Shubham-Khandelwal1/Aerionix_BLDC_health/bldc_health/EASYEDA_MODELS/LGA-24_L3.0-W3.0-P0.40-TL.step

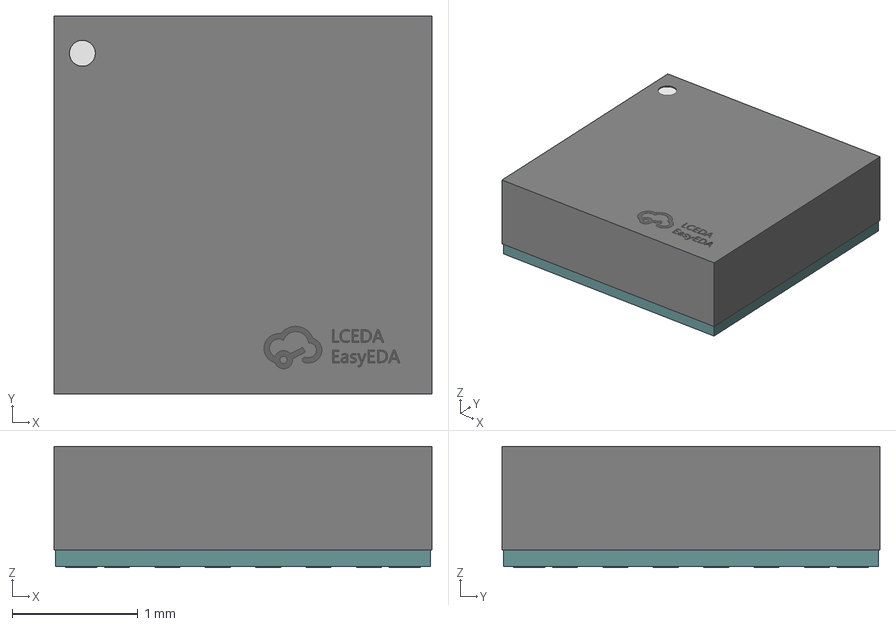
[picture p1: CAD file, 2026-09-08]
bldc_health/EASYEDA_MODELS/LGA-24_L3.0-W3.0-P0.40-TL.step
3.00 x 3.00 x 0.961 mm
