Shubham-Khandelwal1/Aerionix_BLDC_health/bldc_health/footprints_aerionix/TS09-63-25-WT-160-SMT-TR/TS09-63-25-WT-160-SMT-TR.step

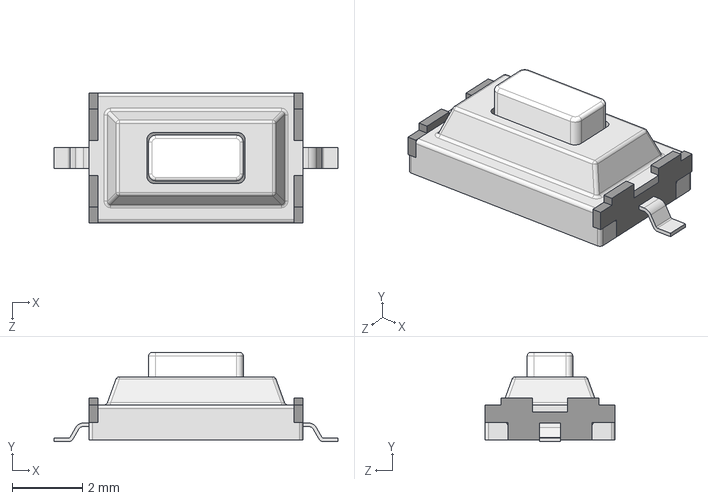
[picture p2: CAD file, 2026-10-23]
bldc_health/footprints_aerionix/TS09-63-25-WT-160-SMT-TR/TS09-63-25-WT-160-SMT-TR.step
8.10 x 2.55 x 3.70 mm
