Shubham-Khandelwal1/Aerionix_BLDC_health/bldc_health/EASYEDA_MODELS/UFQFPN-48_L7.0-W7.0-P0.50-TL-EP5.6.step

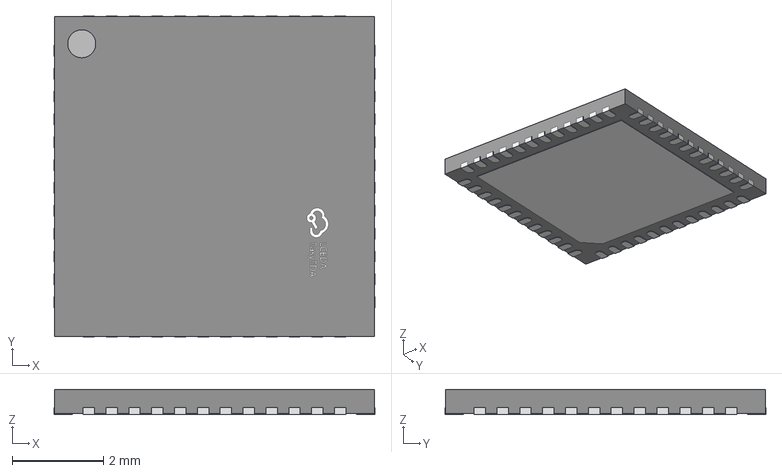
[picture p3: CAD file, 2026-09-08]
bldc_health/EASYEDA_MODELS/UFQFPN-48_L7.0-W7.0-P0.50-TL-EP5.6.step
7.02 x 7.02 x 0.551 mm
