Shubham-Khandelwal1/Aerionix_BLDC_health/bldc_health/EASYEDA_MODELS/LGA-14_L2.5-W3.0-H0.9-P0.50.step

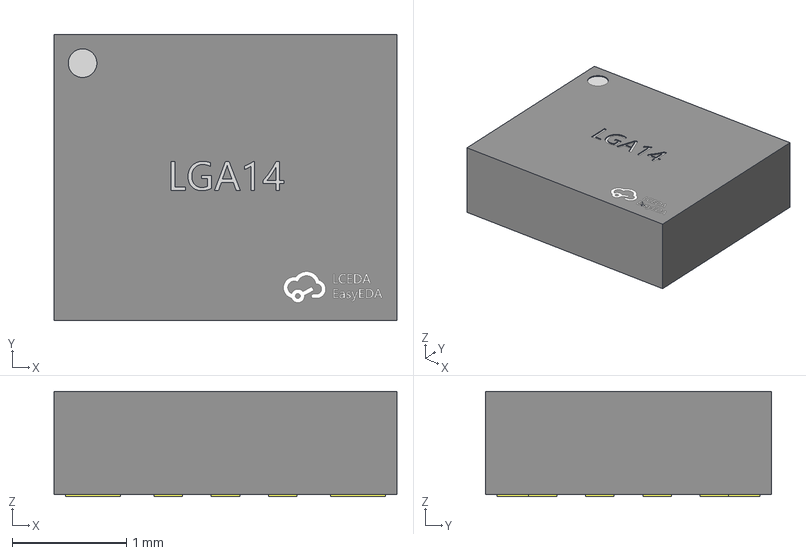
[picture p4: CAD file, 2026-09-08]
bldc_health/EASYEDA_MODELS/LGA-14_L2.5-W3.0-H0.9-P0.50.step
3.00 x 2.50 x 0.921 mm
