Shubham-Khandelwal1/Aerionix_BLDC_health/bldc_health/bldc_health.pdf

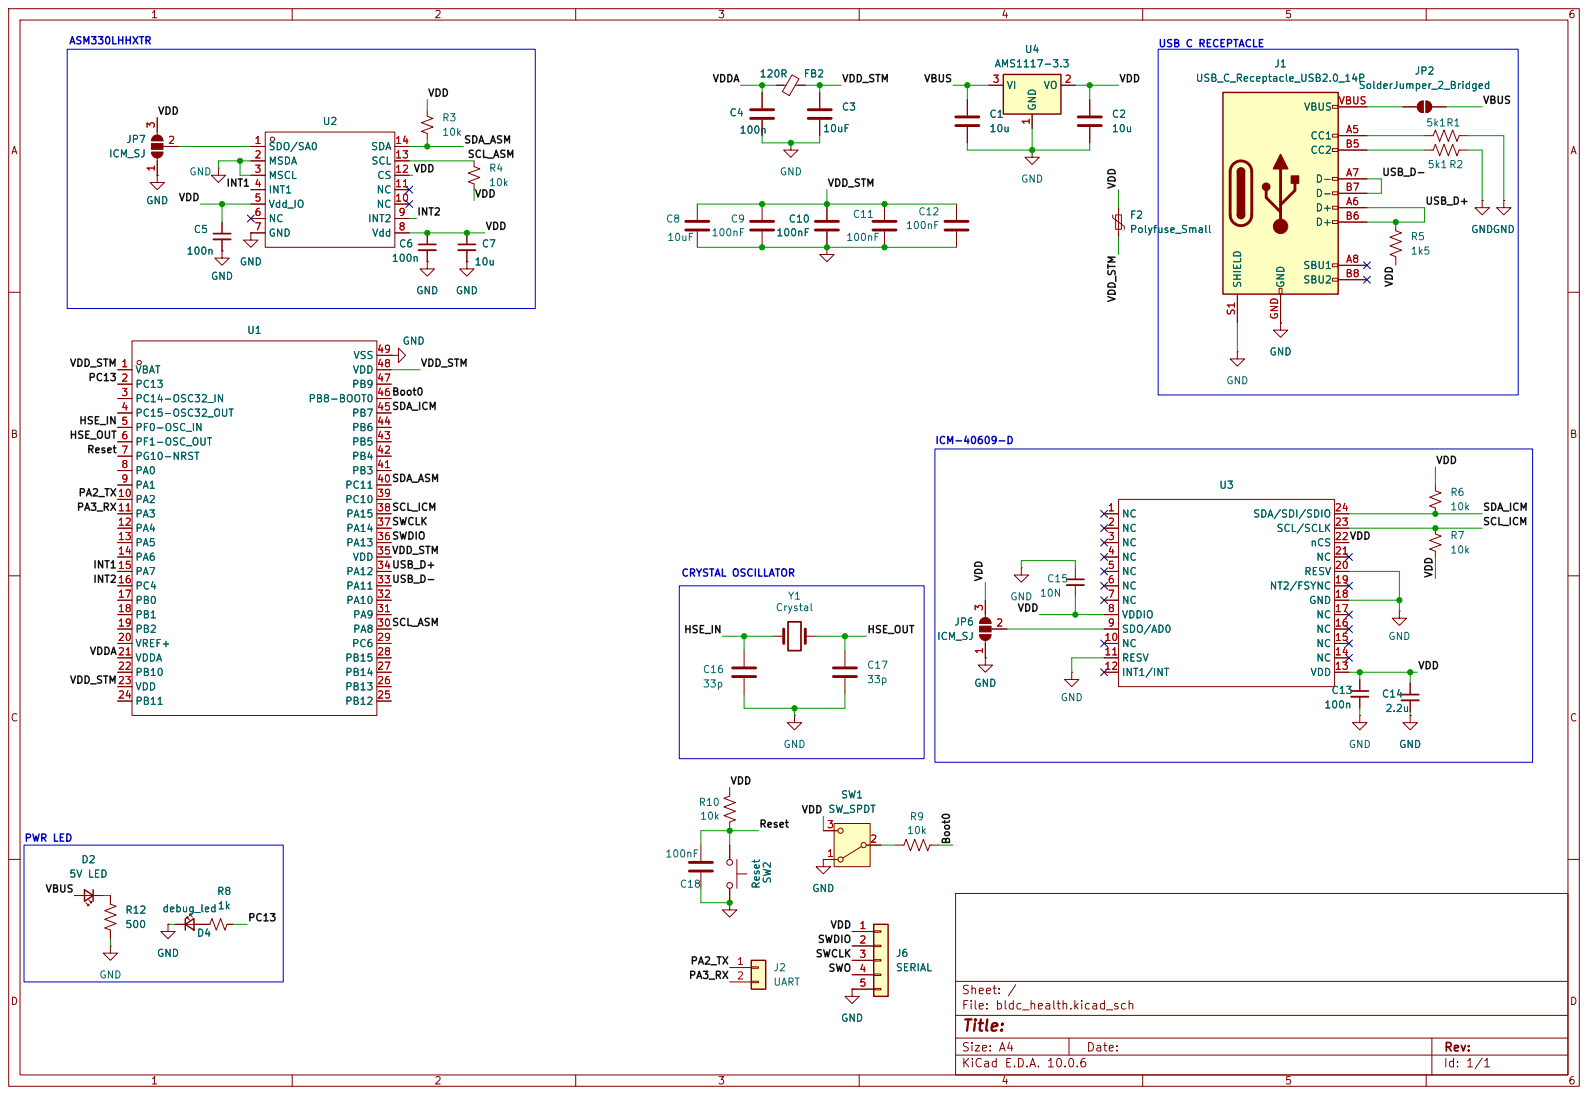
[picture p5: page 1]

Size: A4 | Rev:
KiCad E.D.A. 10.0.6 | Id: 1/1
