Shubham-Khandelwal1/Aerionix_BLDC_health/bldc_health/bldc_health.kicad_pcb

## KiCad design bldc_health/bldc_health.kicad_pcb (2026-10-25)

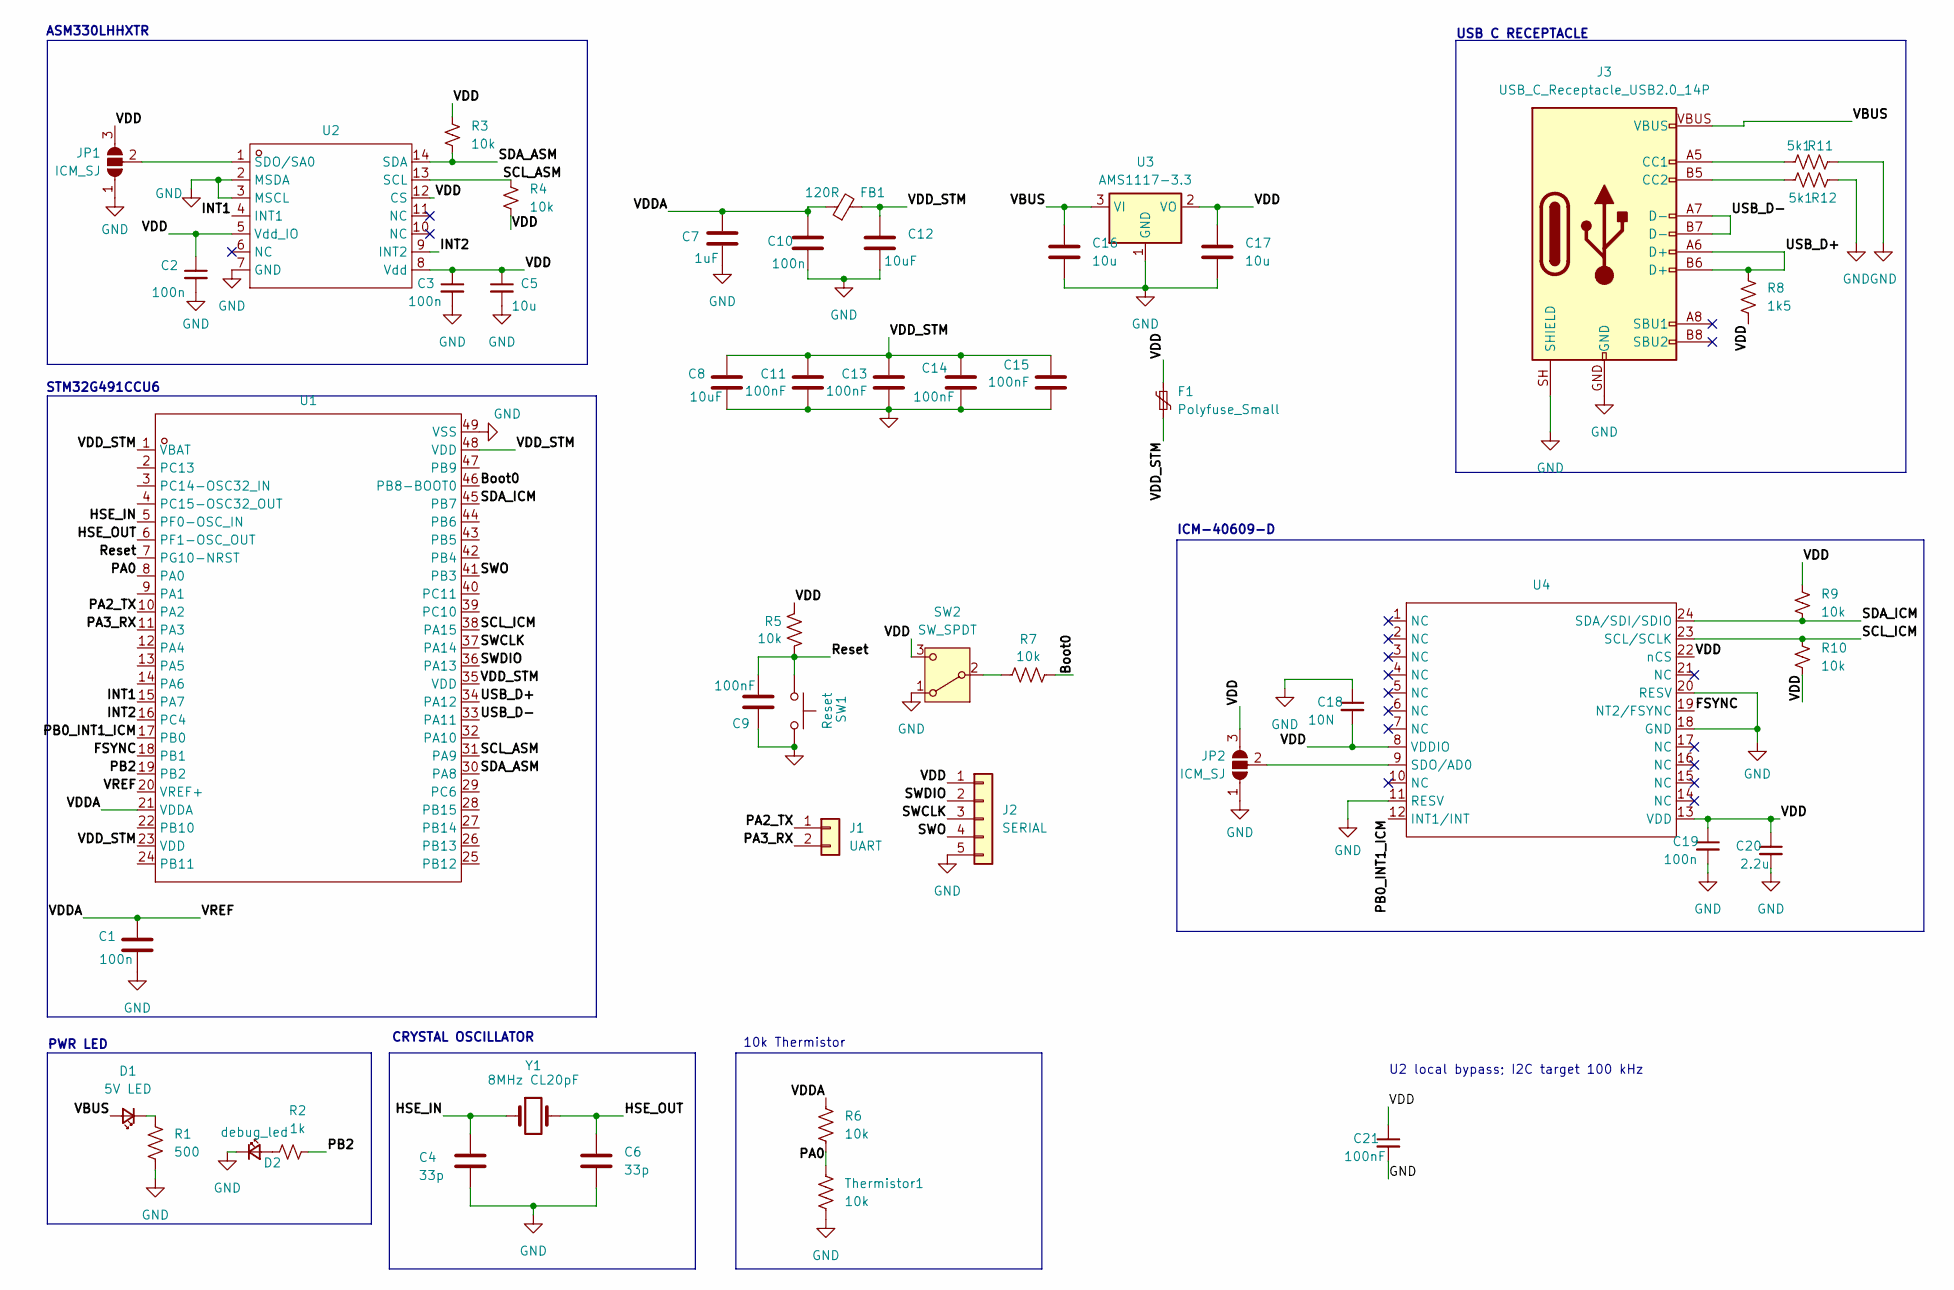
[picture p6: schematic bldc_health.kicad_sch]

Parts:
C1, C2, C3, C10, C19: 100n; C_0603_1608Metric_Pad1.08x0.95mm_HandSolder
C4, C6: 33p; C_0603_1608Metric_Pad1.08x0.95mm_HandSolder
C5, C16, C17: 10u; C_0603_1608Metric_Pad1.08x0.95mm_HandSolder
C7: 1uF; C_0603_1608Metric_Pad1.08x0.95mm_HandSolder
C8, C12: 10uF; C_0603_1608Metric_Pad1.08x0.95mm_HandSolder
C9, C11, C13, C14, C15: 100nF; C_0603_1608Metric_Pad1.08x0.95mm_HandSolder
C18: 10N; C_0603_1608Metric_Pad1.08x0.95mm_HandSolder
C20: 2.2u; C_0603_1608Metric_Pad1.08x0.95mm_HandSolder
C21: 100nF; C_0402_1005Metric
D1: 5V LED; LED_0805_2012Metric_Pad1.15x1.40mm_HandSolder
D2: debug_led; LED_0805_2012Metric_Pad1.15x1.40mm_HandSolder
F1: Polyfuse_Small; Fuse_0603_1608Metric_Pad1.05x0.95mm_HandSolder
FB1: 120R; L_0603_1608Metric_Pad1.05x0.95mm_HandSolder
J1: UART; PinHeader_1x02_P2.54mm_Vertical
J2: SERIAL; PinHeader_1x05_P2.54mm_Vertical
J3: USB_C_Receptacle_USB2.0_14P; USB-C-16P_ARM-PCB
JP1, JP2: ICM_SJ; SolderJumper-3_P1.3mm_Open_Pad1.0x1.5mm
R1: 500; R_0603_1608Metric_Pad0.98x0.95mm_HandSolder
R2: 1k; R_0603_1608Metric_Pad0.98x0.95mm_HandSolder
R3, R4, R5, R6, R7, R9, R10: 10k; R_0603_1608Metric_Pad0.98x0.95mm_HandSolder
R8: 1k5; R_0603_1608Metric_Pad0.98x0.95mm_HandSolder
R11, R12: 5k1; R_0603_1608Metric_Pad0.98x0.95mm_HandSolder
SW1: Reset; SW_TS09-63-25-WT-160-SMT-TR
SW2: SW_SPDT; SW_Slide-03_Wuerth-WS-SLTV_10x2.5x6.4_P2.54mm
Thermistor1: 10k; PinHeader_1x02_P1.00mm_Vertical
U1: UFQFPN-48_L7.0-W7.0-P0.50-TL-EP5.6; Manufacturer Part STM32G491CCU6; LCSC Part Name 主流的 Arm Cortex-M4 微控制器，主频 170 MHz，配备 25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
U2: LGA-14_L3.0-W2.5-P0.50-TL; Manufacturer Part ASM330LHHXTR; LCSC Part Name 高精度6轴汽车惯性测量单元
U3: AMS1117-3.3; SOT-223-3_TabPin2
U4: ICM-40609-D_LGA24_DirectGround; Manufacturer Part ICM-40609-D; LCSC Part Name 6轴MEMS运动跟踪设备
Y1: 8MHz CL20pF; Crystal_SMD_HC49-SD

Connections:
/Boot0: R7.2, U1.46 (PB8-BOOT0)
/FSYNC: U1.18 (PB1), U4.19 (NT2/FSYNC)
/HSE_IN: C4.1, U1.5 (PF0-OSC_IN), Y1.1
/HSE_OUT: C6.1, U1.6 (PF1-OSC_OUT), Y1.2
/INT1: U1.15 (PA7), U2.4 (INT1)
/INT2: U1.16 (PC4), U2.9 (INT2)
/PA0: R6.2, Thermistor1.1, U1.8 (PA0)
/PA2_TX: J1.1, U1.10 (PA2)
/PA3_RX: J1.2, U1.11 (PA3)
/PB0_INT1_ICM: U1.17 (PB0), U4.12 (INT1/INT)
/PB2: R2.2, U1.19 (PB2)
/Reset: C9.2, R5.1, SW1.1, U1.7 (PG10-NRST)
/SCL_ASM: R4.1, U1.31 (PA9), U2.13 (SCL)
/SCL_ICM: R10.1, U1.38 (PA15), U4.23 (SCL/SCLK)
/SDA_ASM: R3.2, U1.30 (PA8), U2.14 (SDA)
/SDA_ICM: R9.2, U1.45 (PB7), U4.24 (SDA/SDI/SDIO)
/SWCLK: J2.3, U1.37 (PA14)
/SWDIO: J2.2, U1.36 (PA13)
/SWO: J2.4, U1.41 (PB3)
/USB_D+: J3.A6 (D+), J3.B6 (D+), R8.1, U1.34 (PA12)
/USB_D-: J3.A7 (D-), J3.B7 (D-), U1.33 (PA11)
/VBUS: C16.1, D1.2 (A), J3.VBUS, U3.3 (VI)
/VDD: C2.1, C3.1, C5.1, C17.1, C18.2, C19.1, C20.1, C21.1, F1.1, J2.1, JP1.3 (B), JP2.3 (B), R3.1, R4.2, R5.2, R8.2, R9.1, R10.2, SW2.3 (C), U2.5 (Vdd_IO), U2.8 (Vdd), U2.12 (CS), U3.2 (VO), U4.8 (VDDIO), U4.13 (VDD), U4.22 (nCS)
/VDDA: C1.1, C7.1, C10.1, FB1.1, R6.1, U1.20 (VREF+), U1.21 (VDDA)
/VDD_STM: C8.1, C11.1, C12.1, C13.1, C14.1, C15.1, F1.2, FB1.2, U1.1 (VBAT), U1.23 (VDD), U1.35 (VDD), U1.48 (VDD)
GND: C1.2, C2.2, C3.2, C4.2, C5.2, C6.2, C7.2, C8.2, C9.1, C10.2, C11.2, C12.2, C13.2, C14.2, C15.2, C16.2, C17.2, C18.1, C19.2, C20.2, C21.2, D2.1 (K), J2.5, J3.GND, J3.SH (SHIELD), JP1.1 (A), JP2.1 (A), R1.2, R11.2, R12.2, SW1.2, SW2.1 (A), Thermistor1.2, U1.49 (VSS), U2.2 (MSDA), U2.3 (MSCL), U2.7 (GND), U3.1 (GND), U4.11 (RESV), U4.18 (GND), U4.20 (RESV); also elsewhere on the board
unnamed: D1.1 (K), R1.1
unnamed: D2.2 (A), R2.1
unnamed: J3.A5 (CC1), R11.1
unnamed: J3.B5 (CC2), R12.1
unnamed: JP1.2 (C), U2.1 (SDO/SA0)
unnamed: JP2.2 (C), U4.9 (SDO/AD0)
unnamed: R7.1, SW2.2 (B)

Notes on the sheet:
STM32G491CCU6
USB C RECEPTACLE
ICM-40609-D
ASM330LHHXTR
10k Thermistor
PWR LED
CRYSTAL OSCILLATOR
U2 local bypass; I2C target 100 kHz

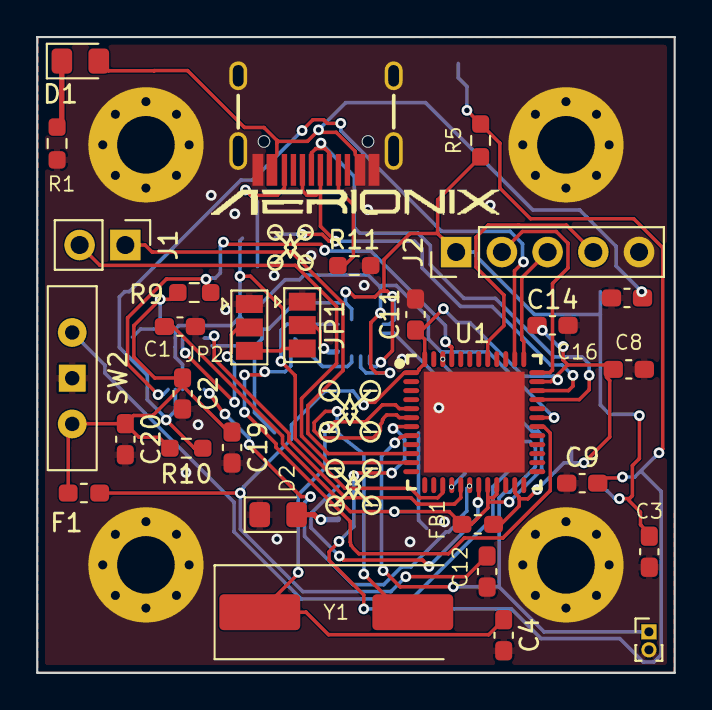
[picture p7: board bldc_health.kicad_pcb from above]

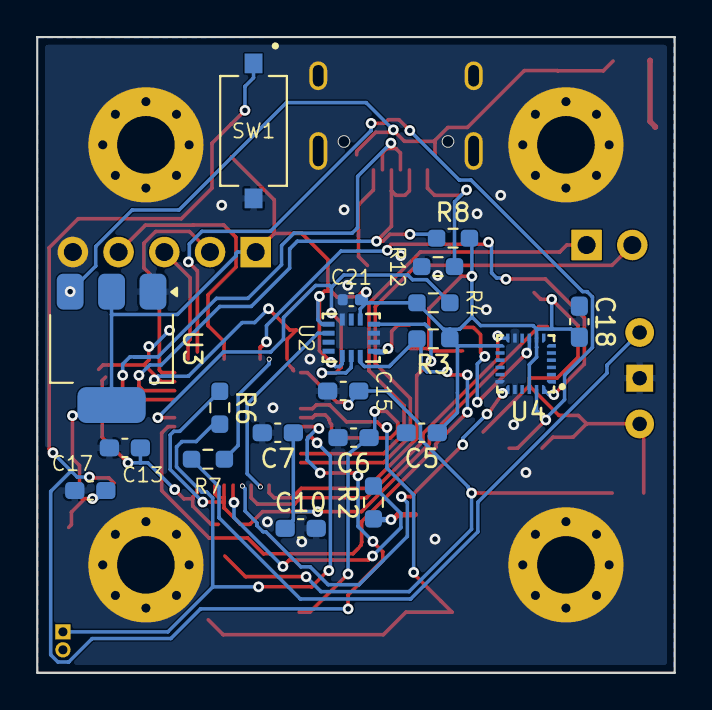
[picture p8: board bldc_health.kicad_pcb from below]

Board: 2 copper layers, 35.4 x 35.3 mm, 54 parts (24 on the bottom side), 33 nets.

Other parts of the board:
MH2, MH5, MH6, MH7: MountingHole_M3; MountingHole_3.2mm_M3_Pad_Via

Their connections:
GND: MH2.1, MH5.1, MH6.1, MH7.1; also elsewhere on the board
