Shubham-Khandelwal1/Aerionix_BLDC_health/(commit log)

2026-10-06 Update PCB design, project configuration, and design rules
    [bldc_health.kicad_pcb]
2026-10-07 changes to pins
    [bldc_health.kicad_pcb, bldc_health.kicad_sch]
2026-10-10 Update PCB layout and schematic
    [bldc_health.kicad_pcb, bldc_health.kicad_sch]
2026-10-23 Update PCB layout, footprints, and schematic
2026-10-23 Back up current PCB and design settings before routing cleanup
2026-10-23 Preserve current open KiCad routing in pre-edit backup
2026-10-23 Improve PCB placement and routing; retain three unresolved connections
2026-10-24 Preserve user PCB and ground-zone edits before review fixes
2026-10-24 Apply verified PCB review fixes before USB footprint replacement
2026-10-25 Preserve current PCB before recheck repairs
2026-10-25 Close PCB connections and resolve routing DRC findings
2026-10-25 Add Aerionix logo and three drone silkscreen graphics
